Copper280z/Teensy_DualMotorBoard_V1/Hardware/Teensy41_DualMotor.kicad_pcb

## KiCad design Hardware/Teensy41_DualMotor.kicad_pcb (2024-01-06)

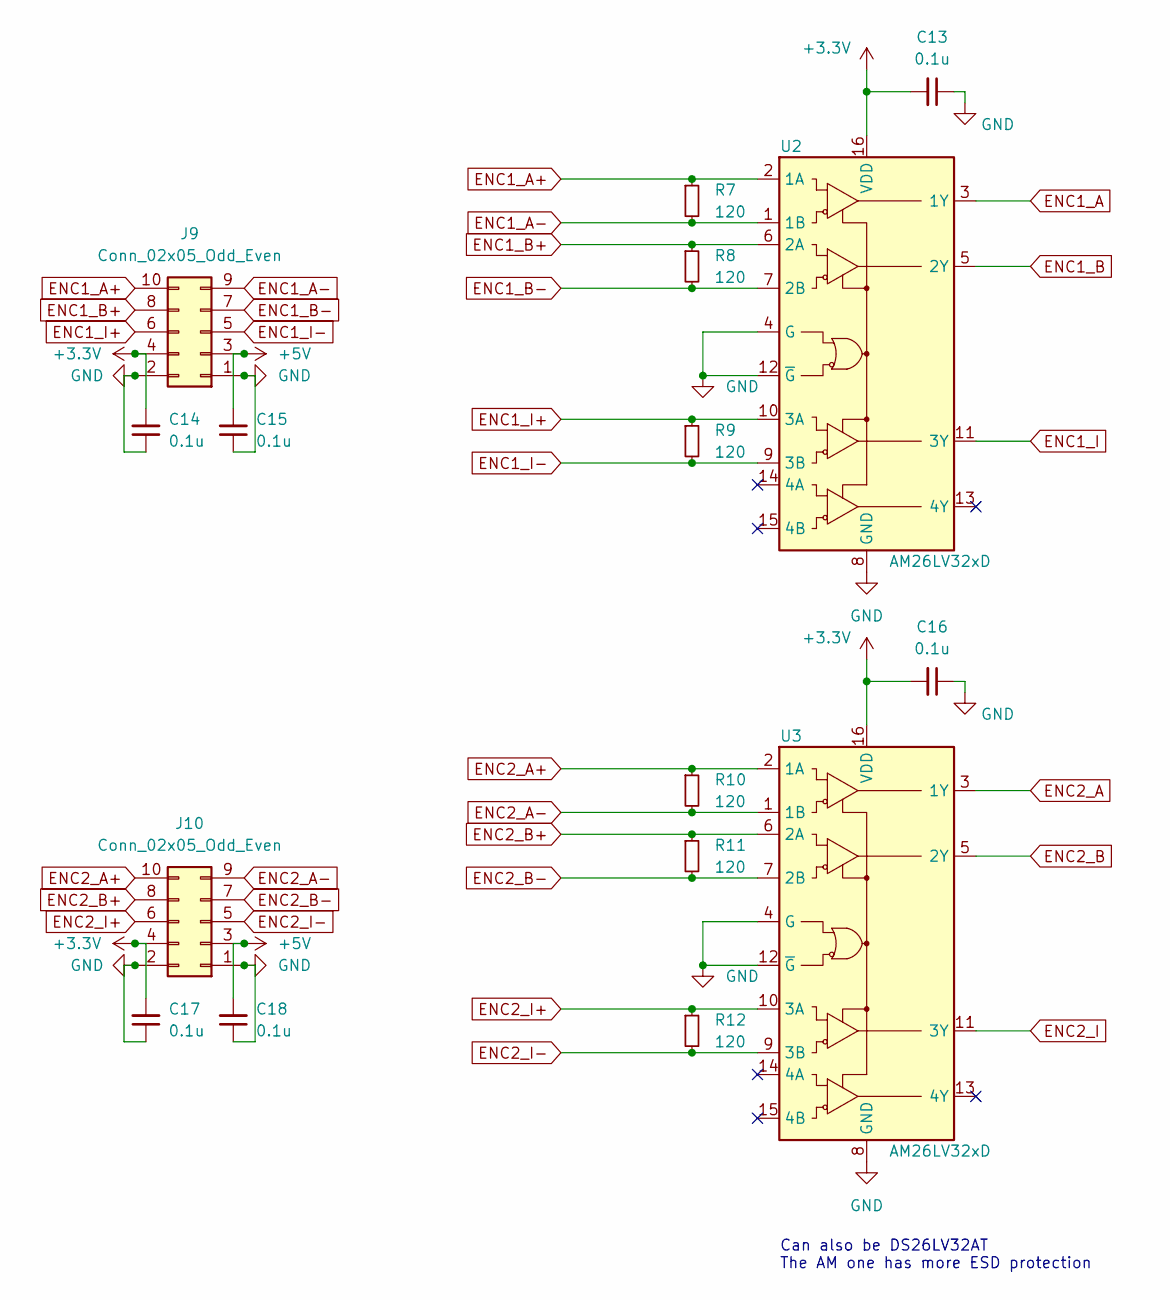
[picture p1: schematic Encoders_input.kicad_sch]

Parts:
C13, C14, C15, C16, C17, C18: 0.1u; C_0603_1608Metric_Pad1.08x0.95mm_HandSolder
J9, J10: Conn_02x05_Odd_Even; PinSocket_2x05_P2.54mm_Vertical
R7, R8, R9, R10, R11, R12: 120; R_0603_1608Metric_Pad0.98x0.95mm_HandSolder
U2, U3: AM26LV32xD; SOIC-16_3.9x9.9mm_P1.27mm

Connections:
+3V3: C13.2, C14.2, C16.2, C17.2, J9.4, J10.4, U2.16 (VDD), U3.16 (VDD); also elsewhere on the board
+5V: C15.2, C18.2, J9.3, J10.3; also elsewhere on the board
ENC1_A: U2.3 (1Y); also elsewhere on the board
ENC1_A+: J9.10, R7.1, U2.2 (1A)
ENC1_A-: J9.9, R7.2, U2.1 (1B)
ENC1_B: U2.5 (2Y); also elsewhere on the board
ENC1_B+: J9.8, R8.1, U2.6 (2A)
ENC1_B-: J9.7, R8.2, U2.7 (2B)
ENC1_I: U2.11 (3Y); also elsewhere on the board
ENC1_I+: J9.6, R9.1, U2.10 (3A)
ENC1_I-: J9.5, R9.2, U2.9 (3B)
ENC2_A: U3.3 (1Y); also elsewhere on the board
ENC2_A+: J10.10, R10.1, U3.2 (1A)
ENC2_A-: J10.9, R10.2, U3.1 (1B)
ENC2_B: U3.5 (2Y); also elsewhere on the board
ENC2_B+: J10.8, R11.1, U3.6 (2A)
ENC2_B-: J10.7, R11.2, U3.7 (2B)
ENC2_I: U3.11 (3Y); also elsewhere on the board
ENC2_I+: J10.6, R12.1, U3.10 (3A)
ENC2_I-: J10.5, R12.2, U3.9 (3B)
GND: C13.1, C14.1, C15.1, C16.1, C17.1, C18.1, J9.1, J9.2, J10.1, J10.2, U2.4 (G), U2.8 (GND), U2.12 (~G), U3.4 (G), U3.8 (GND), U3.12 (~G); also elsewhere on the board

Notes on the sheet:
Can also be DS26LV32AT The AM one has more ESD protection

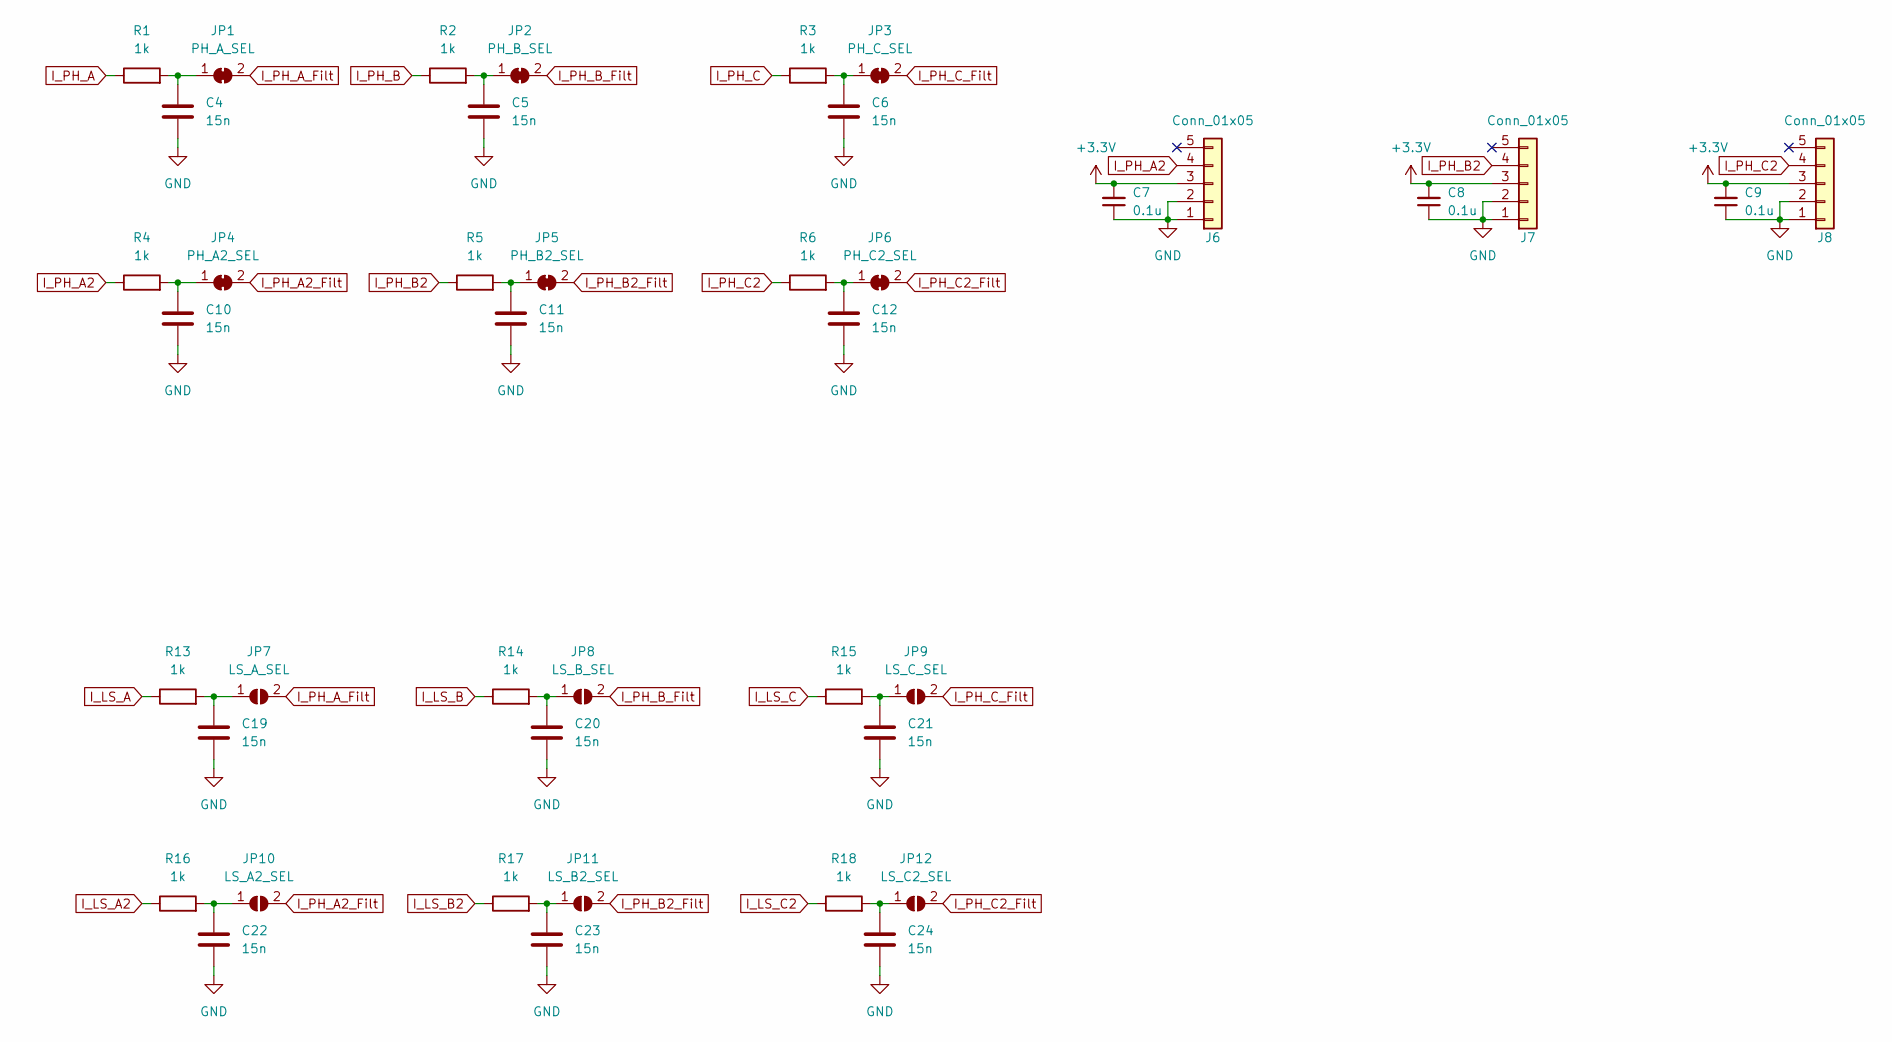
[picture p2: schematic untitled.kicad_sch]

Parts:
C4, C5, C6, C10, C11, C12, C19, C20, C21, C22, C23, C24: 15n; C_0603_1608Metric_Pad1.08x0.95mm_HandSolder
C7, C8, C9: 0.1u; C_0603_1608Metric_Pad1.08x0.95mm_HandSolder
J6, J7, J8: Conn_01x05; PinSocket_1x05_P2.54mm_Vertical
JP1: PH_A_SEL; SolderJumper-2_P1.3mm_Bridged_RoundedPad1.0x1.5mm
JP2: PH_B_SEL; SolderJumper-2_P1.3mm_Bridged_RoundedPad1.0x1.5mm
JP3: PH_C_SEL; SolderJumper-2_P1.3mm_Bridged_RoundedPad1.0x1.5mm
JP4: PH_A2_SEL; SolderJumper-2_P1.3mm_Bridged_RoundedPad1.0x1.5mm
JP5: PH_B2_SEL; SolderJumper-2_P1.3mm_Bridged_RoundedPad1.0x1.5mm
JP6: PH_C2_SEL; SolderJumper-2_P1.3mm_Bridged_RoundedPad1.0x1.5mm
JP7: LS_A_SEL; SolderJumper-2_P1.3mm_Open_RoundedPad1.0x1.5mm
JP8: LS_B_SEL; SolderJumper-2_P1.3mm_Open_RoundedPad1.0x1.5mm
JP9: LS_C_SEL; SolderJumper-2_P1.3mm_Open_RoundedPad1.0x1.5mm
JP10: LS_A2_SEL; SolderJumper-2_P1.3mm_Open_RoundedPad1.0x1.5mm
JP11: LS_B2_SEL; SolderJumper-2_P1.3mm_Open_RoundedPad1.0x1.5mm
JP12: LS_C2_SEL; SolderJumper-2_P1.3mm_Open_RoundedPad1.0x1.5mm
R1, R2, R3, R4, R5, R6, R13, R14, R15, R16, R17, R18: 1k; R_0603_1608Metric_Pad0.98x0.95mm_HandSolder

Connections:
+3V3: C7.2, C8.2, C9.2, J6.3, J7.3, J8.3; also elsewhere on the board
GND: C4.2, C5.2, C6.2, C7.1, C8.1, C9.1, C10.2, C11.2, C12.2, C19.2, C20.2, C21.2, C22.2, C23.2, C24.2, J6.1, J6.2, J7.1, J7.2, J8.1, J8.2; also elsewhere on the board
I_LS_A: R13.1; also elsewhere on the board
I_LS_A2: R16.1; also elsewhere on the board
I_LS_B: R14.1; also elsewhere on the board
I_LS_B2: R17.1; also elsewhere on the board
I_LS_C: R15.1; also elsewhere on the board
I_LS_C2: R18.1; also elsewhere on the board
I_PH_A: R1.1; also elsewhere on the board
I_PH_A2: J6.4, R4.1
I_PH_A2_Filt: JP4.2 (B), JP10.2 (B); also elsewhere on the board
I_PH_A_Filt: JP1.2 (B), JP7.2 (B); also elsewhere on the board
I_PH_B: R2.1; also elsewhere on the board
I_PH_B2: J7.4, R5.1
I_PH_B2_Filt: JP5.2 (B), JP11.2 (B); also elsewhere on the board
I_PH_B_Filt: JP2.2 (B), JP8.2 (B); also elsewhere on the board
I_PH_C: R3.1; also elsewhere on the board
I_PH_C2: J8.4, R6.1
I_PH_C2_Filt: JP6.2 (B), JP12.2 (B); also elsewhere on the board
I_PH_C_Filt: JP3.2 (B), JP9.2 (B); also elsewhere on the board
unnamed: C4.1, JP1.1 (A), R1.2
unnamed: C5.1, JP2.1 (A), R2.2
unnamed: C6.1, JP3.1 (A), R3.2
unnamed: C10.1, JP4.1 (A), R4.2
unnamed: C11.1, JP5.1 (A), R5.2
unnamed: C12.1, JP6.1 (A), R6.2
unnamed: C19.1, JP7.1 (A), R13.2
unnamed: C20.1, JP8.1 (A), R14.2
unnamed: C21.1, JP9.1 (A), R15.2
unnamed: C22.1, JP10.1 (A), R16.2
unnamed: C23.1, JP11.1 (A), R17.2
unnamed: C24.1, JP12.1 (A), R18.2

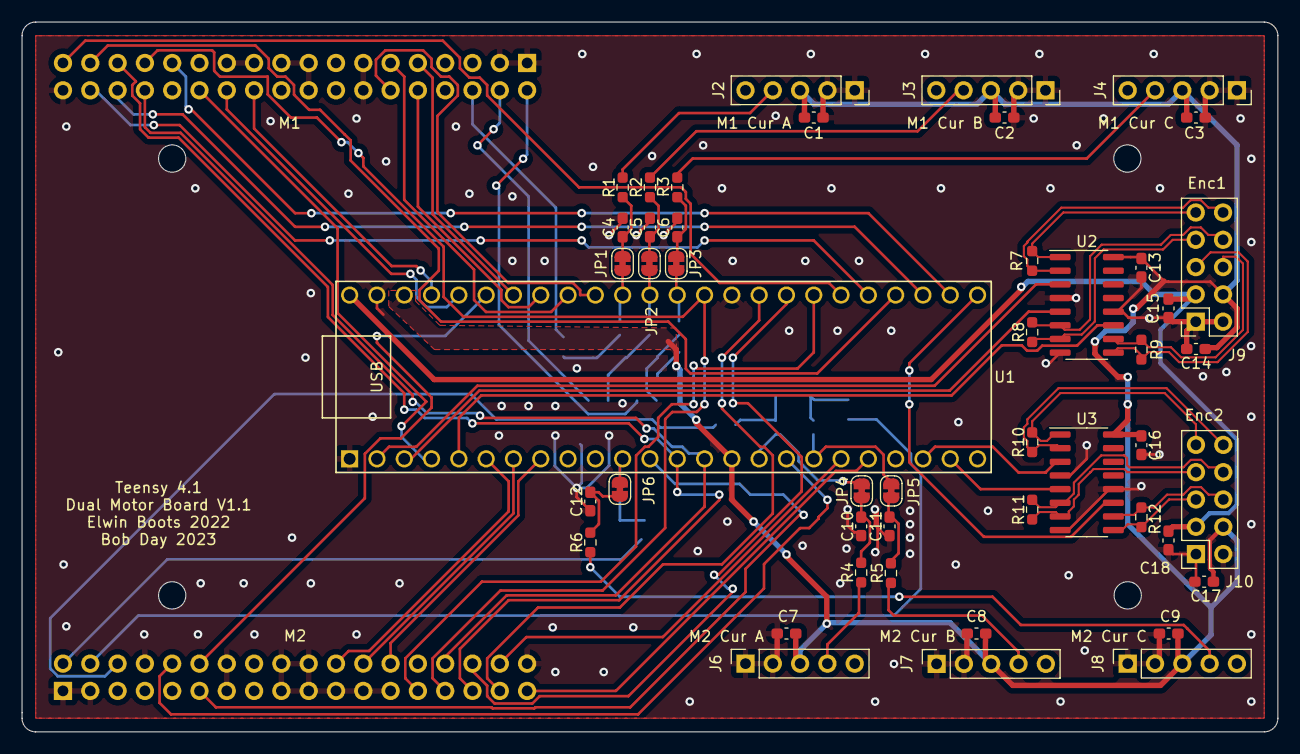
[picture p3: board Teensy41_DualMotor.kicad_pcb from above]

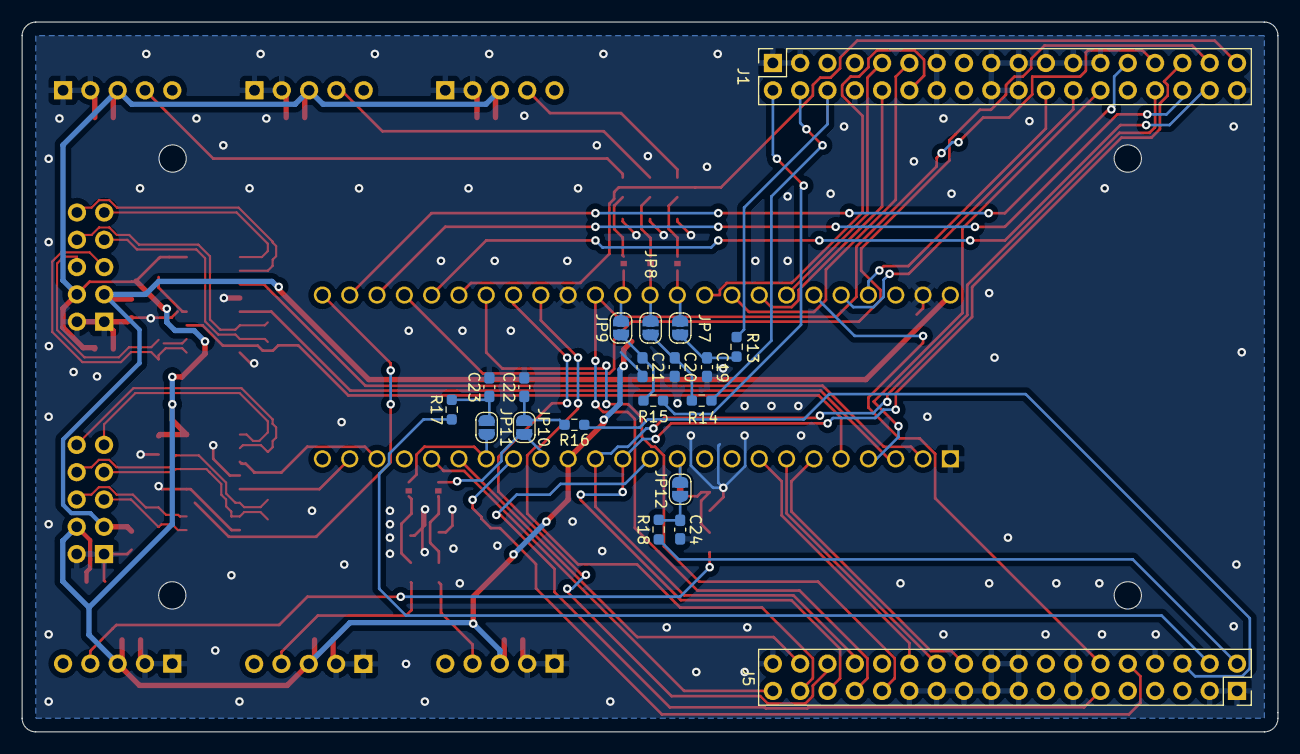
[picture p4: board Teensy41_DualMotor.kicad_pcb from below]

Board: 2 copper layers, 116.8 x 66.0 mm, 67 parts (20 on the bottom side), 77 nets.

Other parts of the board:
C1, C2, C3: 0.1u; C_0603_1608Metric_Pad1.08x0.95mm_HandSolder
J1, J5: Conn_02x18_Odd_Even; PinSocket_2x18_P2.54mm_Vertical
J2, J3, J4: Conn_01x05; PinSocket_1x05_P2.54mm_Vertical
U1: Teensy4.1; Teensy41

Their connections:
+3V3: C1.2, C2.2, C3.2, J2.3, J3.3, J4.3, U1.15 (3V3), U1.46 (3V3); also elsewhere on the board
+5V: U1.48 (VIN); also elsewhere on the board
EMF-A: J1.11, U1.40 (18_A4_SDA)
EMF-A2: J5.11, U1.12 (10_CS_MQSR)
EMF-B: J1.10, U1.41 (19_A5_SCL)
EMF-B2: J5.10, U1.17 (25_A11_RX6_SDA2)
EMF-C: J1.9, U1.42 (20_A6_TX5_LRCLK1)
EN-GATE: J1.27, U1.26 (34_RX8)
EN-GATE2: J5.27, U1.31 (39_MISO1_OUT1A)
ENC1_A: U1.2 (0_RX1_CRX2_CS1); also elsewhere on the board
ENC1_B: U1.3 (1_TX1_CTX2_MISO1); also elsewhere on the board
ENC1_I: U1.5 (3_LRCLK2); also elsewhere on the board
ENC2_A: U1.22 (30_CRX3); also elsewhere on the board
ENC2_B: U1.23 (31_CTX3); also elsewhere on the board
ENC2_I: U1.25 (33_MCLK2); also elsewhere on the board
GND: C1.1, C2.1, C3.1, J1.1, J1.3, J1.8, J1.13, J1.14, J1.17, J1.18, J1.19, J1.20, J1.21, J1.23, J1.25, J1.36, J2.1, J2.2, J3.1, J3.2, J4.1, J4.2, J5.1, J5.3, J5.8, J5.13, J5.14, J5.17, J5.18, J5.19, J5.20, J5.21, J5.23, J5.25, J5.36, U1.1 (GND), U1.34 (GND), U1.47 (GND); also elsewhere on the board
INH-A: J1.26, U1.4 (2_OUT2)
INH-A2: J5.26, U1.8 (6_OUT1D)
INH-B: J1.24, U1.44 (22_A8_CTX1)
INH-B2: J5.24, U1.7 (5_IN2)
INH-C: J1.22, U1.45 (23_A9_CRX1_MCLK1)
INH-C2: J5.22, U1.6 (4_BCLK2)
I_LS_A: J1.6; also elsewhere on the board
I_LS_A2: J5.6; also elsewhere on the board
I_LS_B: J1.4; also elsewhere on the board
I_LS_B2: J5.4; also elsewhere on the board
I_LS_C: J1.2; also elsewhere on the board
I_LS_C2: J5.2; also elsewhere on the board
I_PH_A: J2.4; also elsewhere on the board
I_PH_A2_Filt: U1.16 (24_A10_TX6_SCL2); also elsewhere on the board
I_PH_A_Filt: U1.38 (16_A2_RX4_SCL1); also elsewhere on the board
I_PH_B: J3.4; also elsewhere on the board
I_PH_B2_Filt: U1.18 (26_A12_MOSI1); also elsewhere on the board
I_PH_B_Filt: U1.37 (15_A1_RX3_SPDIF_IN); also elsewhere on the board
I_PH_C: J4.4; also elsewhere on the board
I_PH_C2_Filt: U1.11 (9_OUT1C); also elsewhere on the board
I_PH_C_Filt: U1.36 (14_A0_TX3_SPDIF_OUT); also elsewhere on the board
PWRGD: J1.35, U1.30 (38_CS1_IN1)
PWRGD2: J5.35, U1.20 (28_RX7)
SCLK: J1.29, J5.29, U1.35 (13_SCK_LED)
SDI: J1.31, J5.31, U1.13 (11_MOSI_CTX1)
SDO: J1.30, J5.30, U1.14 (12_MISO_MQSL)
VPDD-O: J1.12, U1.39 (17_A3_TX4_SDA1)
VPDD-O2: J5.12, U1.43 (21_A7_RX5_BCLK1)
nFAULT: J1.33, U1.28 (36_CS)
nFAULT2: J5.33, U1.33 (41_A17)
nOCTW: J1.34, U1.29 (37_CS)
nOCTW2: J5.34, U1.19 (27_A13_SCK1)
nSCS: J1.32, U1.27 (35_TX8)
nSCS2: J5.32, U1.32 (40_A16)
