Copper280z/Teensy_DualMotorBoard_V1/Software/stream_object.py

# -*- coding: utf-8 -*-
"""
Created on Sat Oct  7 14:51:16 2023

@author: elwin
"""

Fplayback = round(1/m.Ts)
N_samples_per_write = 100
bufsize = 10000
musicgain = 0.5

import scipy
folder = '~/Downloads'

#%%
(Fs , data) = scipy.io.wavfile.read( folder + "AC⧸DC - Thunderstruck (Official Video).wav")

stream = data[200*Fs:300*Fs]
stream = scipy.signal.resample(stream , int(len(stream)/Fs*Fplayback) ) 
#%%
(Fs , data) = scipy.io.wavfile.read( '../../../Downloads/still_alive.wav')

stream = data[6*Fs:]
stream = scipy.signal.resample(stream , int(len(stream)/Fs*Fplayback) ) 
stream = np.sum(stream,axis=1)

#%%
(Fs , data) = scipy.io.wavfile.read( folder + "8D Audio Bass Test !!.wav")

stream = data
stream = scipy.signal.resample(stream , int(len(stream)/Fs*Fplayback) ) 
#%%
(Fs , data) = scipy.io.wavfile.read( folder + "Martin Garrix - Animals (Official Video).wav")

stream = data[77*Fs:300*Fs]
stream = scipy.signal.resample(stream , int(len(stream)/Fs*Fplayback) ) 
#%%
(Fs , data) = scipy.io.wavfile.read( folder + "Jedi Mind Tricks Presents： Army Of The Pharaohs - ＂Dump The Clip＂ [Official Audio].wav")

stream = data[8*Fs:]
stream = scipy.signal.resample(stream , int(len(stream)/Fs*Fplayback) ) 
#%%
(Fs , data) = scipy.io.wavfile.read( folder + "Eminem, Dr. Dre - Forgot About Dre (Explicit) (Official Music Video) ft. Hittman.wav")

stream = data
stream = scipy.signal.resample(stream , int(len(stream)/Fs*Fplayback) ) 
#%%
(Fs , data) = scipy.io.wavfile.read( folder + "Lights On ▶ FNAF SECURITY BREACH SONG.wav")

stream = data
stream = scipy.signal.resample(stream , int(len(stream)/Fs*Fplayback) ) 





#%%
stream = stream / np.max(np.abs(stream))
L = len(stream)

m.setpar('s1.runstream' , 0)
m.setpar('s1.curbuffer' , 0)
# m.setpar('s2.runstream' , 0)
# m.setpar('s2.curbuffer' , 0)

for i in range( int(bufsize /N_samples_per_write) ):
   m.setparpart( 's1.streambuffer' ,  stream[ i*N_samples_per_write : (i+1)*N_samples_per_write ] , startlocation = np.mod(i*N_samples_per_write , bufsize ) )
   # m.setparpart( 's2.streambuffer' ,  stream[ i*N_samples_per_write : (i+1)*N_samples_per_write , 0] , startlocation = np.mod(i*N_samples_per_write , bufsize ) )

m.setpar('s1.runstream' , 1)
# m.setpar('s2.runstream' , 1)
m.setpar('s1.buffergain' , 1.5)
# m.setpar('s2.buffergain' , musicgain)

# m.vel([-20 , 20])
try:
    end = int( (L-bufsize) /N_samples_per_write)
    for i in range( end ):
        # if i == int(end/6):
        #     m.vel([20 , -20])
        # if i == int(end/3):
        #     m.vel([-20 , 20])
        # if i == int(end/2):
        #     m.vel([0 , 0])
        startloc = np.mod(i*N_samples_per_write , bufsize )
        while (startloc  <= m.getsig('s1.curbuffer') <= startloc + N_samples_per_write):
            pass
        m.setparpart( 's1.streambuffer' ,  stream[ i*N_samples_per_write + bufsize: (i+1)*N_samples_per_write + bufsize ] , startlocation = startloc )
        # m.setparpart( 's2.streambuffer' ,  stream[ i*N_samples_per_write + bufsize: (i+1)*N_samples_per_write + bufsize , 0] , startlocation = startloc )
        # print((i+1)*N_samples_per_write + bufsize)
except:
    time.sleep(0.1)   
    m.ser.flushInput()  
    print('Canceled')
  
m.setpar('s1.buffergain' , 0)
# m.setpar('s2.buffergain' , 0)
m.setpar('s1.runstream' , 0)
# m.setpar('s2.runstream' , 0)
