Copper280z/Teensy_DualMotorBoard_V1/(commit log)

2024-01-06 added filters and solder bridges to select low side current sense or external inline current sense
    [Encoders_input.kicad_sch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]
2024-01-16 added some macros to firmware for LS vs inline current sense
2024-01-22 working hfi with 2805 gimbal motor
2024-01-24 works well with 2805 motor
2024-01-25 generated trace file for inductance lookup, turned up accel and jerk more for setpoint moves
2024-02-23 add script for characterizing motors
2024-02-27 added 4215 motor file and anticog calibration script
2024-02-27 minor update for motor characterization
2024-12-08 remove some filtering in anticog impl, add measuring in both directions
2024-12-09 bug fixes and revisions, add iterative building of cogging map
    [anticog.py]
